photo-bot23/Photo-Bot/Photo-Bot Engineering Drawings/ELECTRONICS ARRANGEMENT.PDF

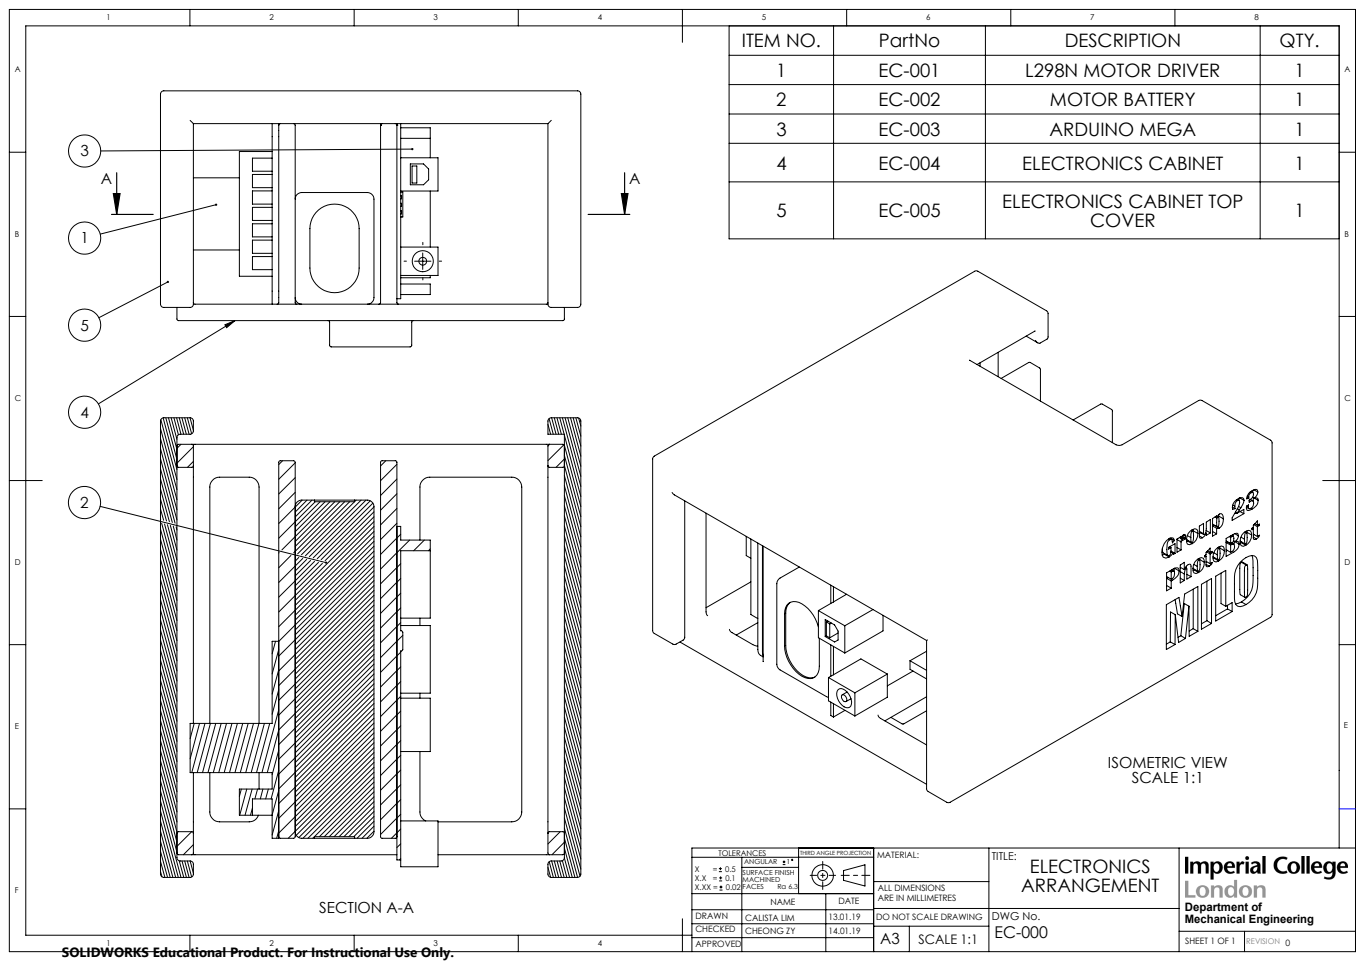
[picture p1: page 1]
ISOMETRIC VIEW SCALE 1:1; SECTION A-A; SURFACE FINISH; FACES; ANGULAR 1; DWG No.; A3 SCALE 1:1; SHEET 1 OF 1; CALISTA LIM CHEONG ZY; REVISION 0; Department of Mechanical Engineering

ITEM NO. | PartNo | DESCRIPTION | QTY.
1 | EC-001 | L298N MOTOR DRIVER | 1
2 | EC-002 | MOTOR BATTERY | 1
3 | EC-003 | ARDUINO MEGA | 1
4 | EC-004 | ELECTRONICS CABINET | 1
5 | EC-005 | ELECTRONICS CABINET TOP COVER | 1

THIRD ANGLE PROJECTION

ALL DIMENSIONS
ARE IN MILLIMETRES
DO NOT SCALE DRAWING

SOLIDWORKS Educational Product. For Instructional Use Only.
