photo-bot23/Photo-Bot/Photo-Bot Engineering Drawings/FRONT SUBASSEMBLY.PDF

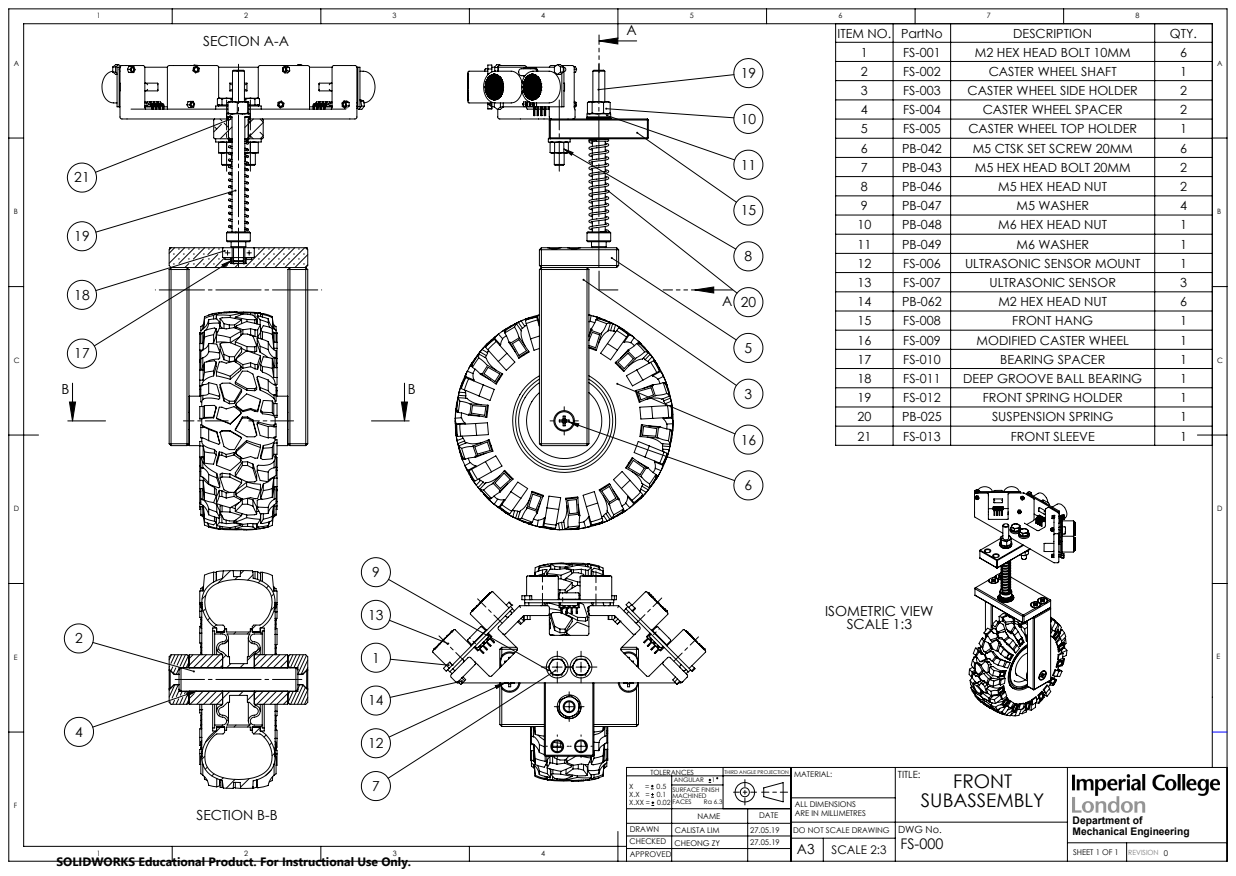
[picture p2: page 1]
ISOMETRIC VIEW SCALE 1:3; SECTION A-A; SECTION B-B; SURFACE FINISH; FACES; ANGULAR 1; FRONT; DWG No.; A3 SCALE 2:3; SHEET 1 OF 1; CALISTA LIM CHEONG ZY; REVISION 0; Department of Mechanical Engineering

ITEM NO. | PartNo | DESCRIPTION | QTY.
1 | FS-001 | M2 HEX HEAD BOLT 10MM | 6
2 | FS-002 | CASTER WHEEL SHAFT | 1
3 | FS-003 | CASTER WHEEL SIDE HOLDER | 2
4 | FS-004 | CASTER WHEEL SPACER | 2
5 | FS-005 | CASTER WHEEL TOP HOLDER | 1
6 | PB-042 | M5 CTSK SET SCREW 20MM | 6
7 | PB-043 | M5 HEX HEAD BOLT 20MM | 2
8 | PB-046 | M5 HEX HEAD NUT | 2
9 | PB-047 | M5 WASHER | 4
10 | PB-048 | M6 HEX HEAD NUT | 1
11 | PB-049 | M6 WASHER | 1
12 | FS-006 | ULTRASONIC SENSOR MOUNT | 1
13 | FS-007 | ULTRASONIC SENSOR | 3
14 | PB-062 | M2 HEX HEAD NUT | 6
15 | FS-008 | FRONT HANG | 1
16 | FS-009 | MODIFIED CASTER WHEEL | 1
17 | FS-010 | BEARING SPACER | 1
18 | FS-011 | DEEP GROOVE BALL BEARING | 1
19 | FS-012 | FRONT SPRING HOLDER | 1
20 | PB-025 | SUSPENSION SPRING | 1
21 | FS-013 | FRONT SLEEVE | 1

THIRD ANGLE PROJECTION

ALL DIMENSIONS
ARE IN MILLIMETRES
DO NOT SCALE DRAWING

SOLIDWORKS Educational Product. For Instructional Use Only.
