photo-bot23/Photo-Bot/Photo-Bot Engineering Drawings/GIMBAL ASSEMBLY.PDF

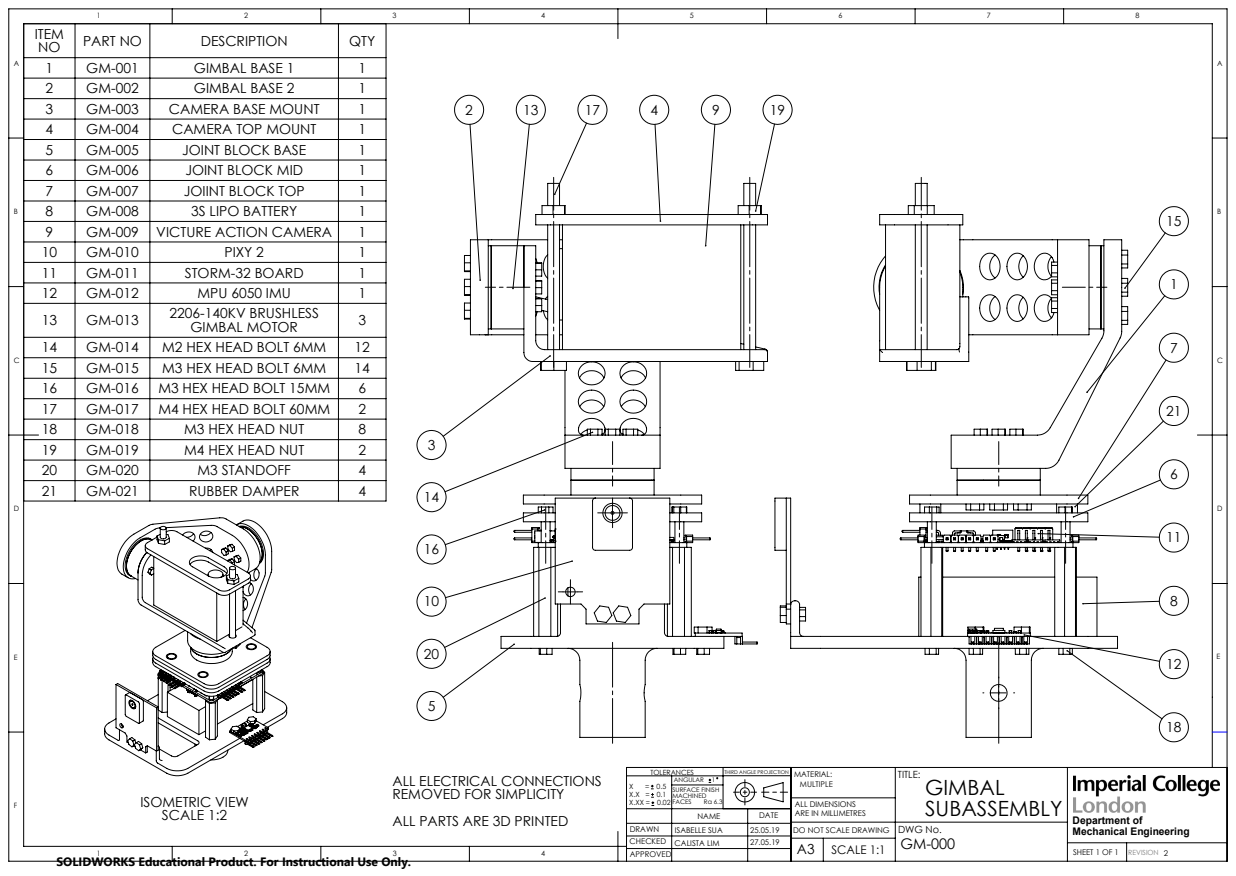
[picture p3: page 1]
ISOMETRIC VIEW SCALE 1:2; SURFACE FINISH; FACES; ANGULAR 1; DWG No.; A3 SCALE 1:1; SHEET 1 OF 1; ISABELLE SUA CALISTA LIM; REVISION 2; Department of Mechanical Engineering

ITEM NO | PART NO | DESCRIPTION | QTY
1 | GM-001 | GIMBAL BASE 1 | 1
2 | GM-002 | GIMBAL BASE 2 | 1
3 | GM-003 | CAMERA BASE MOUNT | 1
4 | GM-004 | CAMERA TOP MOUNT | 1
5 | GM-005 | JOINT BLOCK BASE | 1
6 | GM-006 | JOINT BLOCK MID | 1
7 | GM-007 | JOIINT BLOCK TOP | 1
8 | GM-008 | 3S LIPO BATTERY | 1
9 | GM-009 | VICTURE ACTION CAMERA | 1
10 | GM-010 | PIXY 2 | 1
11 | GM-011 | STORM-32 BOARD | 1
12 | GM-012 | MPU 6050 IMU | 1
13 | GM-013 | 2206-140KV BRUSHLESS GIMBAL MOTOR | 3
14 | GM-014 | M2 HEX HEAD BOLT 6MM | 12
15 | GM-015 | M3 HEX HEAD BOLT 6MM | 14
16 | GM-016 | M3 HEX HEAD BOLT 15MM | 6
17 | GM-017 | M4 HEX HEAD BOLT 60MM | 2
18 | GM-018 | M3 HEX HEAD NUT | 8
19 | GM-019 | M4 HEX HEAD NUT | 2
20 | GM-020 | M3 STANDOFF | 4
21 | GM-021 | RUBBER DAMPER | 4

THIRD ANGLE PROJECTION

MATERIAL:
MULTIPLE
ALL DIMENSIONS
ARE IN MILLIMETRES
DO NOT SCALE DRAWING

ALL ELECTRICAL CONNECTIONS
REMOVED FOR SIMPLICITY
ALL PARTS ARE 3D PRINTED

SOLIDWORKS Educational Product. For Instructional Use Only.
