photo-bot23/Photo-Bot/Photo-Bot Engineering Drawings/FRONT SUBASSEMBLY/FS-002 CASTER WHEEL SHAFT.PDF

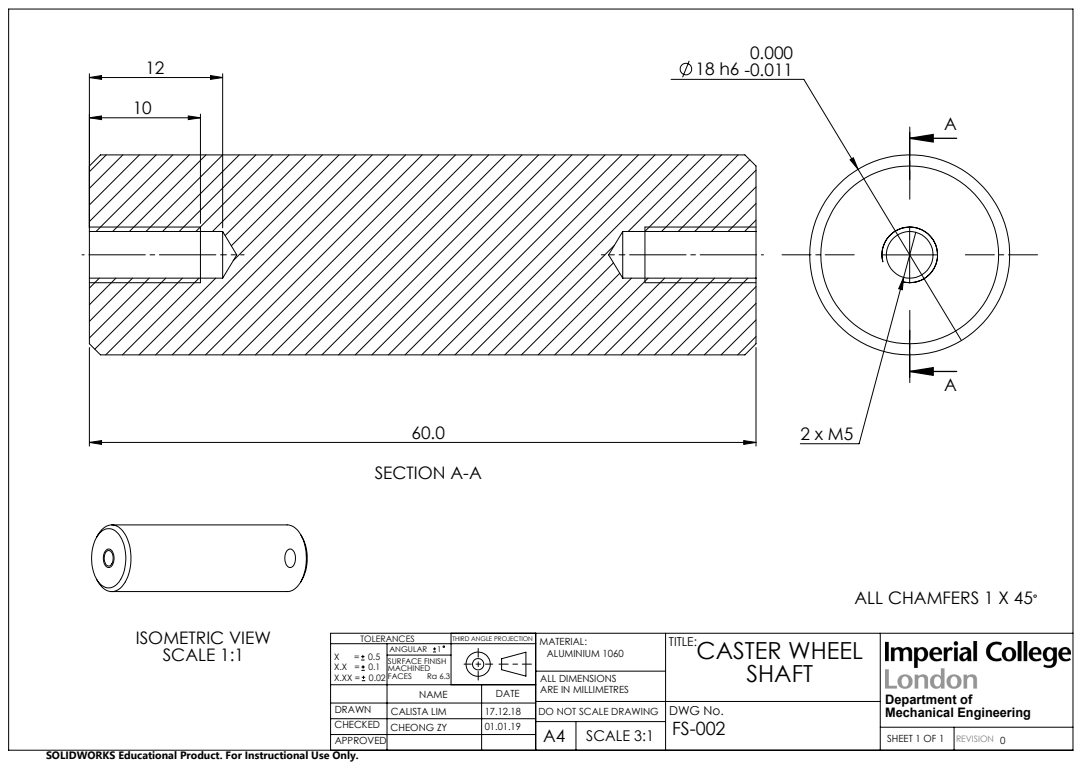
[picture p4: page 1]
SECTION A-A; ALL CHAMFERS 1 X 45°; ISOMETRIC VIEW; SCALE 1:1; SURFACE FINISH; FACES; ANGULAR 1; CASTER WHEEL; DWG No.; A4 SCALE 3:1; SHEET 1 OF 1; CALISTA LIM CHEONG ZY; REVISION 0; Department of Mechanical Engineering

THIRD ANGLE PROJECTION

MATERIAL:
ALUMINIUM 1060
ALL DIMENSIONS
ARE IN MILLIMETRES
DO NOT SCALE DRAWING

SOLIDWORKS Educational Product. For Instructional Use Only.
