photo-bot23/Photo-Bot/Photo-Bot Engineering Drawings/FRONT SUBASSEMBLY/FS-003 CASTER WHEELSIDE HOLDER.PDF

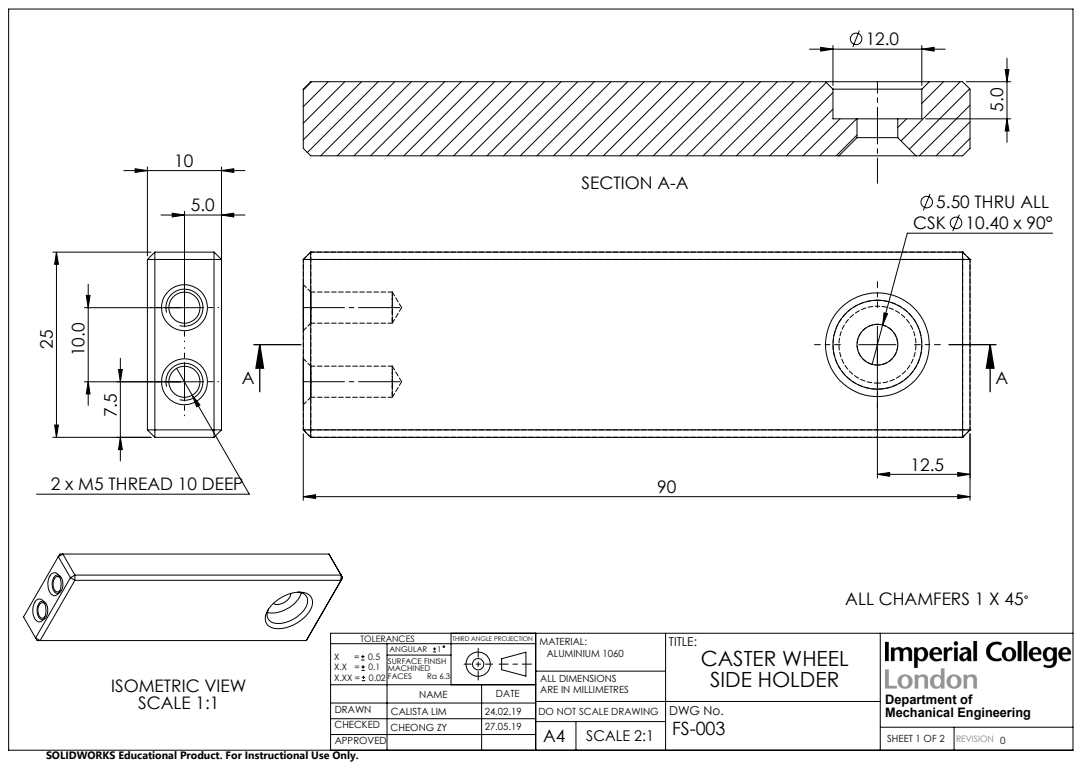
[picture p5: page 1]
5.50 THRU ALL CSK 10.40 x 90°; SECTION A-A; 2 x M5 THREAD 10 DEEP; ISOMETRIC VIEW SCALE 1:1; ALL CHAMFERS 1 X 45°; SURFACE FINISH; FACES; ANGULAR 1; CASTER WHEEL SIDE HOLDER; DWG No.; A4 SCALE 2:1; SHEET 1 OF 2; CALISTA LIM CHEONG ZY; REVISION 0; Department of Mechanical Engineering

THIRD ANGLE PROJECTION

MATERIAL:
ALUMINIUM 1060
ALL DIMENSIONS
ARE IN MILLIMETRES
DO NOT SCALE DRAWING

SOLIDWORKS Educational Product. For Instructional Use Only.
