photo-bot23/Photo-Bot/Photo-Bot Engineering Drawings/FRONT SUBASSEMBLY/FS-004 CASTER WHEEL SPACER.PDF

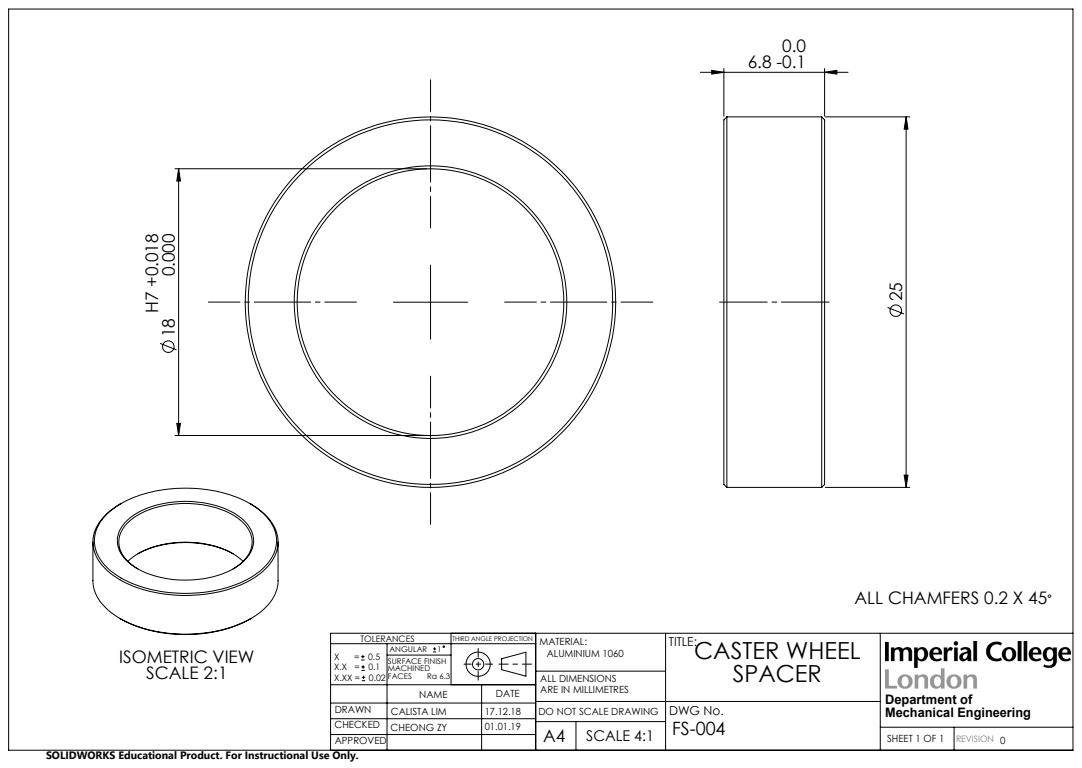
[picture p6: page 1]
ISOMETRIC VIEW SCALE 2:1; ALL CHAMFERS 0.2 X 45°; SURFACE FINISH; FACES; ANGULAR 1; CASTER WHEEL; DWG No.; A4 SCALE 4:1; SHEET 1 OF 1; CALISTA LIM CHEONG ZY; REVISION 0; Department of Mechanical Engineering

THIRD ANGLE PROJECTION

MATERIAL:
ALUMINIUM 1060
ALL DIMENSIONS
ARE IN MILLIMETRES
DO NOT SCALE DRAWING

SOLIDWORKS Educational Product. For Instructional Use Only.
