photo-bot23/Photo-Bot/Photo-Bot Engineering Drawings/FRONT SUBASSEMBLY/FS-005 CASTER WHEEL TOP HOLDER.PDF

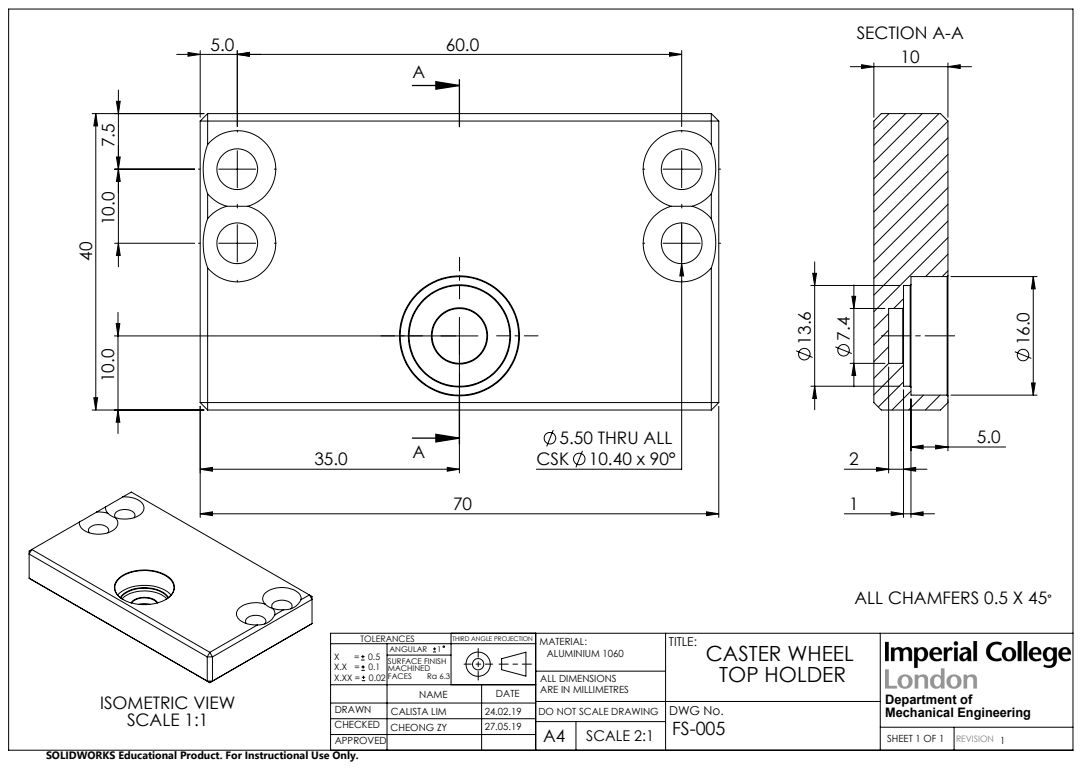
[picture p7: page 1]
5.50 THRU ALL CSK 10.40 x 90°; SECTION A-A; ALL CHAMFERS 0.5 X 45°; ISOMETRIC VIEW SCALE 1:1; SURFACE FINISH; FACES; ANGULAR 1; CASTER WHEEL TOP HOLDER; DWG No.; A4 SCALE 2:1; SHEET 1 OF 1; CALISTA LIM CHEONG ZY; REVISION 1; Department of Mechanical Engineering

THIRD ANGLE PROJECTION

MATERIAL:
ALUMINIUM 1060
ALL DIMENSIONS
ARE IN MILLIMETRES
DO NOT SCALE DRAWING

SOLIDWORKS Educational Product. For Instructional Use Only.
