photo-bot23/Photo-Bot/Photo-Bot Engineering Drawings/FRONT SUBASSEMBLY/FS-010 BEARING SPACER.PDF

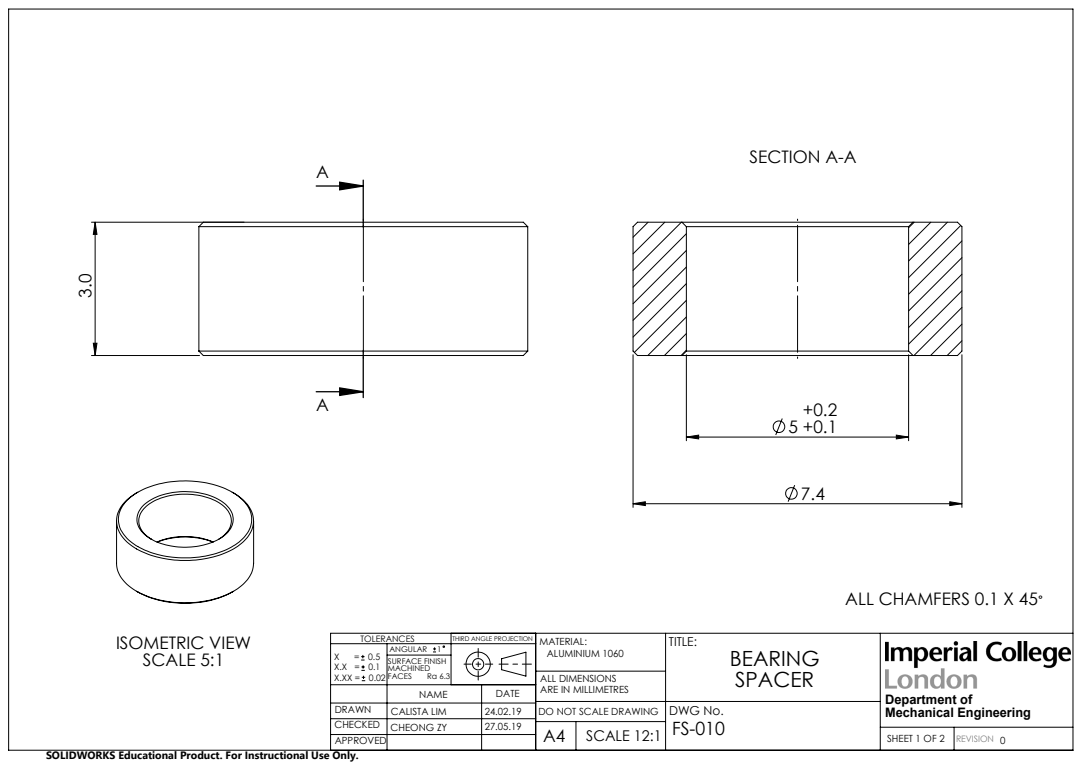
[picture p8: page 1]
SECTION A-A; ALL CHAMFERS 0.1 X 45°; ISOMETRIC VIEW; SCALE 5:1; SURFACE FINISH; FACES; ANGULAR 1; DWG No.; A4 SCALE 12:1; SHEET 1 OF 2; CALISTA LIM CHEONG ZY; REVISION 0; Department of Mechanical Engineering

THIRD ANGLE PROJECTION

MATERIAL:
ALUMINIUM 1060
ALL DIMENSIONS
ARE IN MILLIMETRES
DO NOT SCALE DRAWING

SOLIDWORKS Educational Product. For Instructional Use Only.
