photo-bot23/Photo-Bot/Photo-Bot Engineering Drawings/FRONT SUBASSEMBLY/FS-012 FRONT SPRING HOLDER.PDF

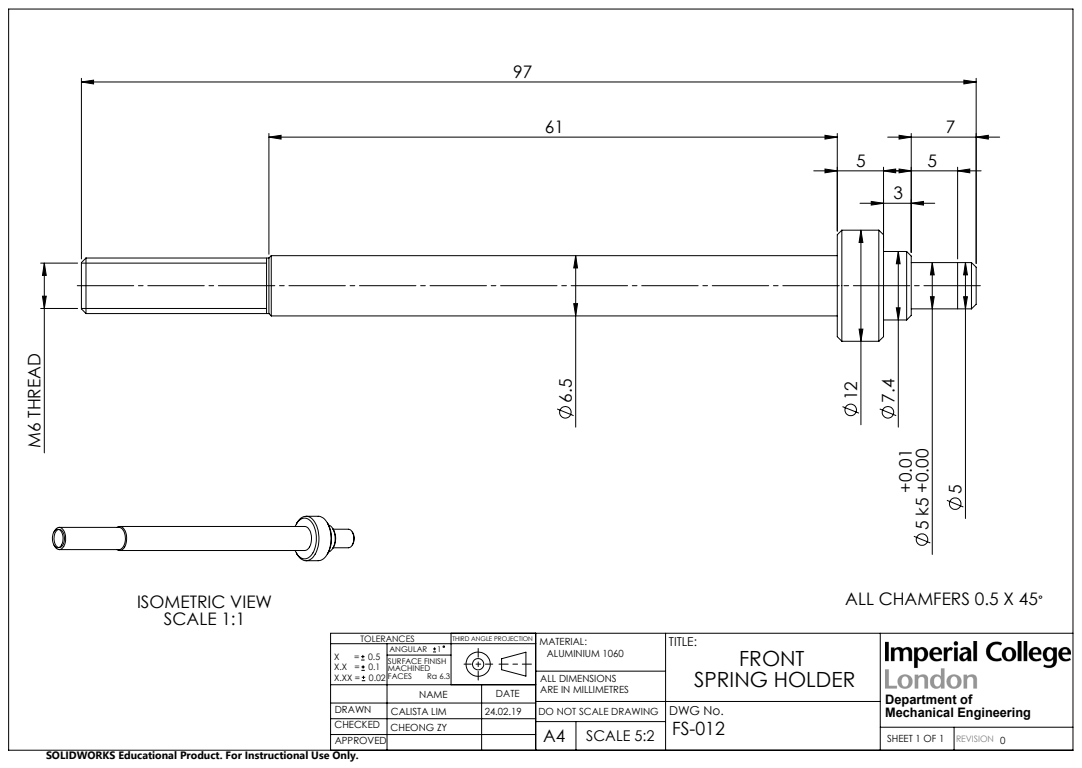
[picture p9: page 1]
M6 THREAD; ISOMETRIC VIEW SCALE 1:1; ALL CHAMFERS 0.5 X 45°; SURFACE FINISH; FACES; ANGULAR 1; SPRING HOLDER; DWG No.; A4 SCALE 5:2; SHEET 1 OF 1; CALISTA LIM CHEONG ZY; REVISION 0; Department of Mechanical Engineering

THIRD ANGLE PROJECTION

MATERIAL:
ALUMINIUM 1060
ALL DIMENSIONS
ARE IN MILLIMETRES
DO NOT SCALE DRAWING

SOLIDWORKS Educational Product. For Instructional Use Only.
