photo-bot23/Photo-Bot/Photo-Bot Engineering Drawings/FRONT SUBASSEMBLY/FS-013 FRONT SLEEVE.PDF

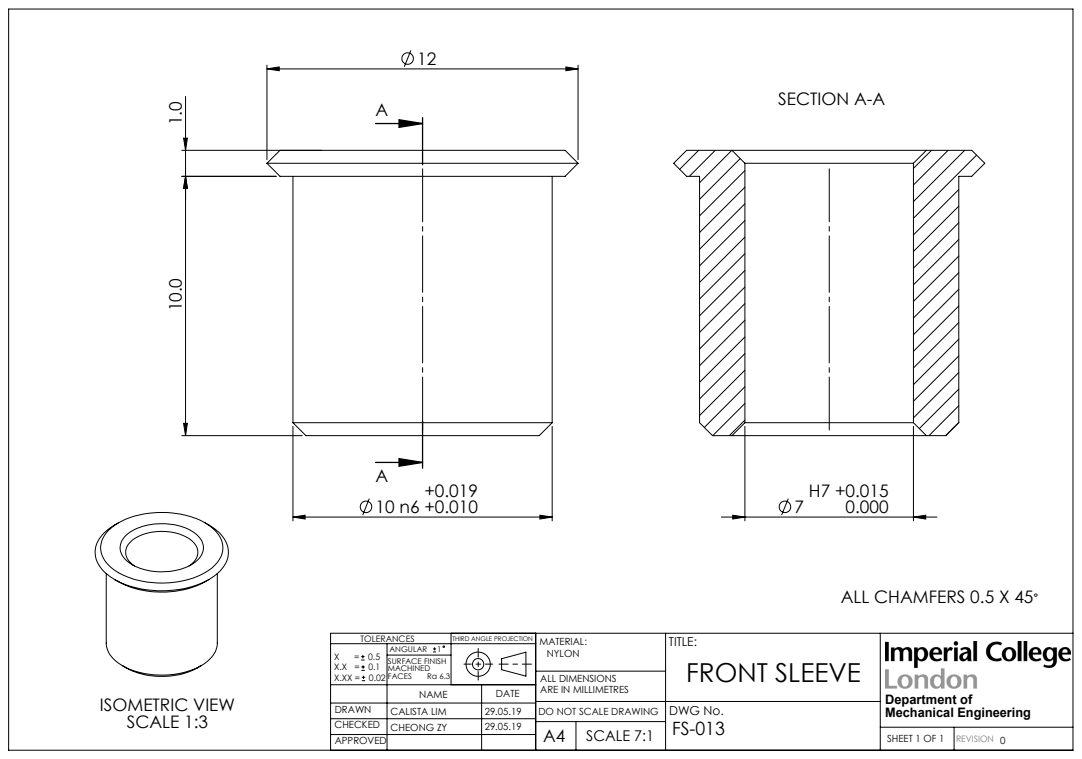
[picture p10: page 1]
SECTION A-A; ISOMETRIC VIEW SCALE 1:3; ALL CHAMFERS 0.5 X 45°; SURFACE FINISH; FACES; ANGULAR 1; FRONT SLEEVE; DWG No.; A4 SCALE 7:1; SHEET 1 OF 1; CALISTA LIM CHEONG ZY; REVISION 0; Department of Mechanical Engineering

THIRD ANGLE PROJECTION

MATERIAL:
NYLON
ALL DIMENSIONS
ARE IN MILLIMETRES
DO NOT SCALE DRAWING
