photo-bot23/Photo-Bot/Photo-Bot Engineering Drawings/MAIN PHOTOBOT/PB-004 25MM HINGE PIN.PDF

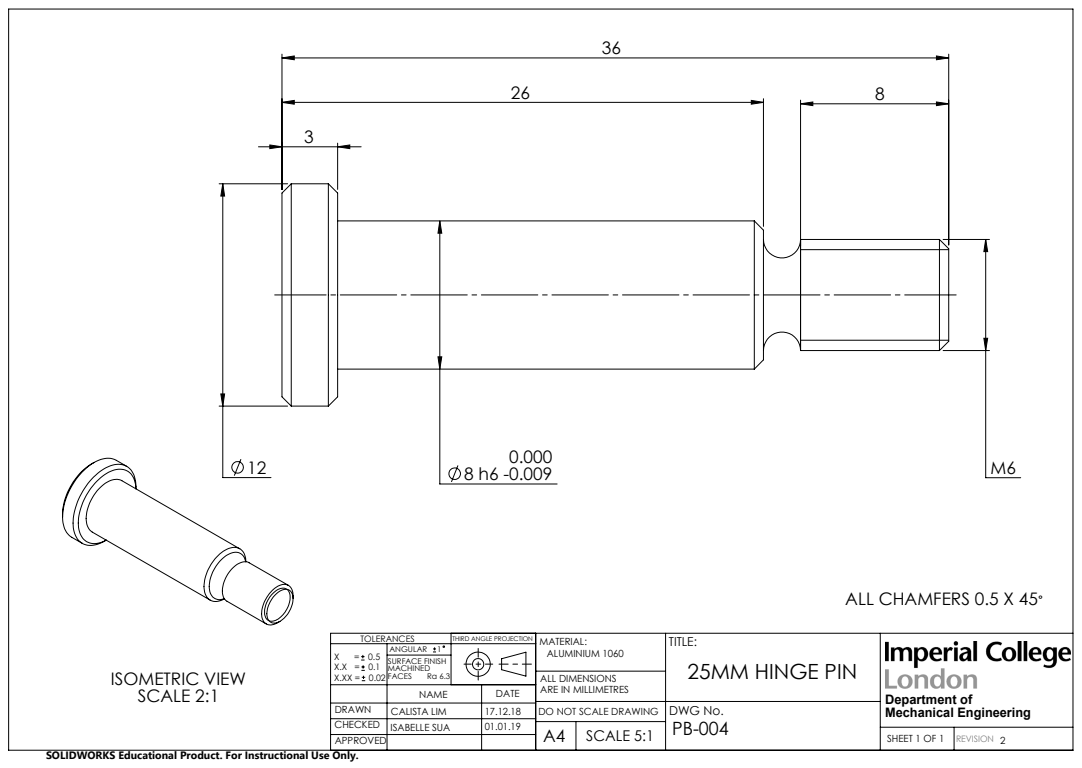
[picture p14: page 1]
ISOMETRIC VIEW SCALE 2:1; ALL CHAMFERS 0.5 X 45°; SURFACE FINISH; FACES; ANGULAR 1; 25MM HINGE PIN; DWG No.; A4 SCALE 5:1; SHEET 1 OF 1; CALISTA LIM ISABELLE SUA; REVISION 2; Department of Mechanical Engineering

THIRD ANGLE PROJECTION

MATERIAL:
ALUMINIUM 1060
ALL DIMENSIONS
ARE IN MILLIMETRES
DO NOT SCALE DRAWING

SOLIDWORKS Educational Product. For Instructional Use Only.
