photo-bot23/Photo-Bot/Photo-Bot Engineering Drawings/MAIN PHOTOBOT/PB-005 FRONT BAR.PDF

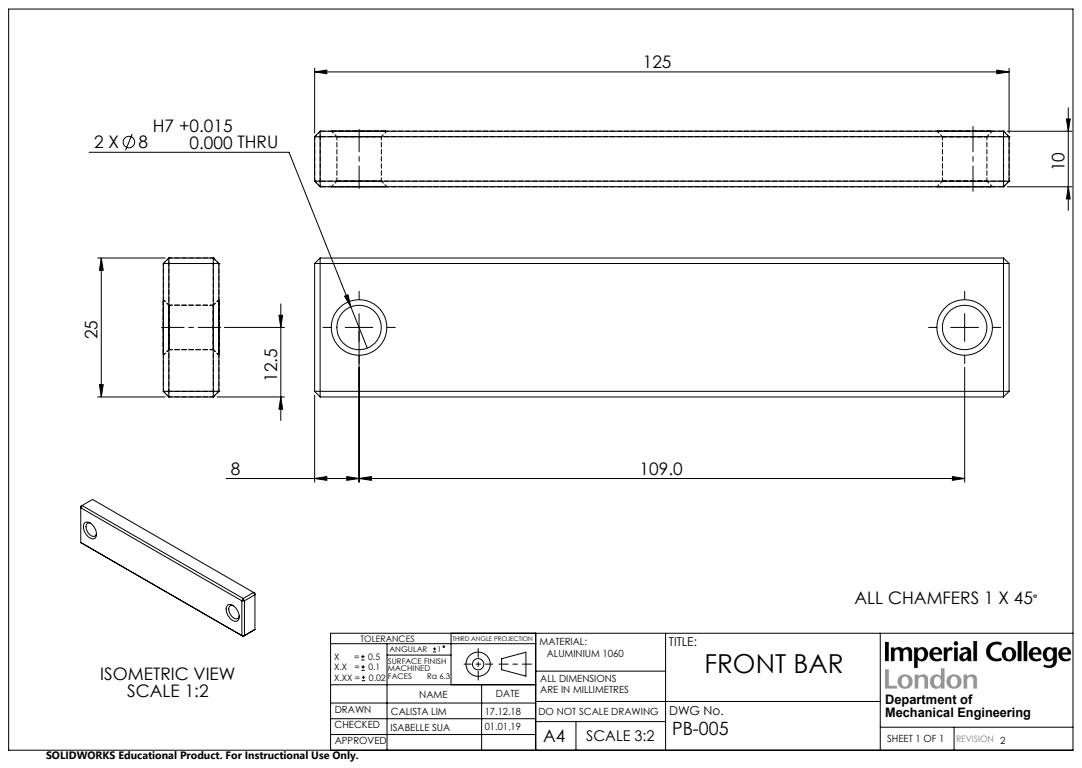
[picture p15: page 1]
H7 +0.015 0.000 THRU; ALL CHAMFERS 1 X 45°; ISOMETRIC VIEW SCALE 1:2; SURFACE FINISH; FACES; ANGULAR 1; FRONT BAR; DWG No.; A4 SCALE 3:2; SHEET 1 OF 1; CALISTA LIM ISABELLE SUA; REVISION 2; Department of Mechanical Engineering

THIRD ANGLE PROJECTION

MATERIAL:
ALUMINIUM 1060
ALL DIMENSIONS
ARE IN MILLIMETRES
DO NOT SCALE DRAWING

SOLIDWORKS Educational Product. For Instructional Use Only.
