photo-bot23/Photo-Bot/Photo-Bot Engineering Drawings/MAIN PHOTOBOT/PB-007 HEIGHT SPACER.PDF

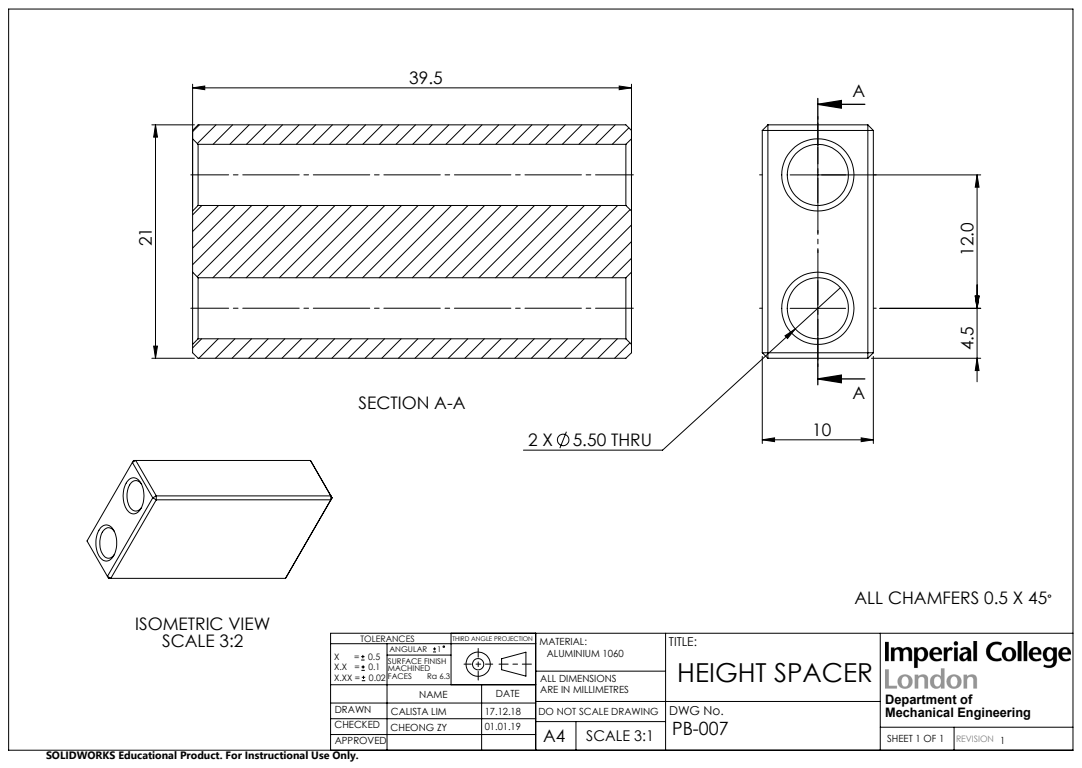
[picture p16: page 1]
10 2 X 5.50 THRU; SECTION A-A; ISOMETRIC VIEW SCALE 3:2; ALL CHAMFERS 0.5 X 45°; SURFACE FINISH; FACES; ANGULAR 1; HEIGHT SPACER; DWG No.; A4 SCALE 3:1; SHEET 1 OF 1; CALISTA LIM CHEONG ZY; REVISION 1; Department of Mechanical Engineering

THIRD ANGLE PROJECTION

MATERIAL:
ALUMINIUM 1060
ALL DIMENSIONS
ARE IN MILLIMETRES
DO NOT SCALE DRAWING

SOLIDWORKS Educational Product. For Instructional Use Only.
