photo-bot23/Photo-Bot/Photo-Bot Engineering Drawings/MAIN PHOTOBOT/PB-008 MAST HINGE BLOCK.PDF

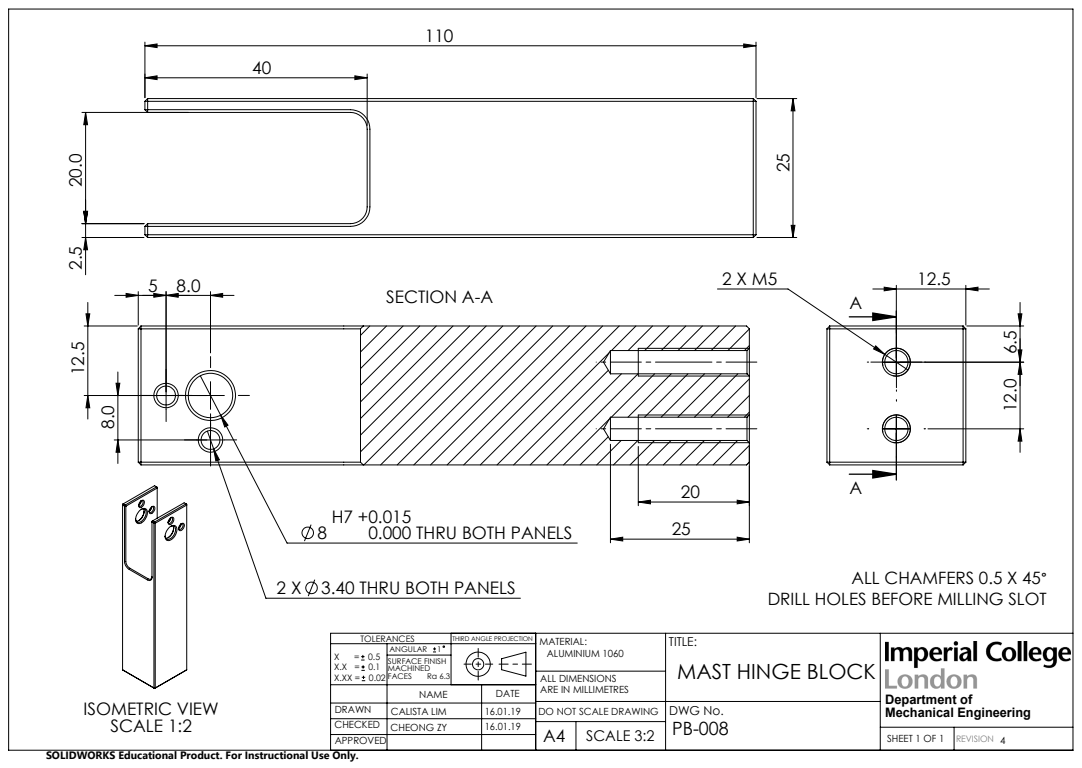
[picture p17: page 1]
H7 +0.015 0.000 THRU BOTH PANELS; SECTION A-A; ALL CHAMFERS 0.5 X 45°; ISOMETRIC VIEW SCALE 1:2; SURFACE FINISH; FACES; ANGULAR 1; DWG No.; A4 SCALE 3:2; SHEET 1 OF 1; CALISTA LIM CHEONG ZY; REVISION 4; Department of Mechanical Engineering

2 X 3.40 THRU BOTH PANELS

DRILL HOLES BEFORE MILLING SLOT

THIRD ANGLE PROJECTION

MATERIAL:
ALUMINIUM 1060
ALL DIMENSIONS
ARE IN MILLIMETRES
DO NOT SCALE DRAWING

TITLE:
MAST HINGE BLOCK

SOLIDWORKS Educational Product. For Instructional Use Only.
