photo-bot23/Photo-Bot/Photo-Bot Engineering Drawings/MAIN PHOTOBOT/PB-012 MOTOR MOUNT BASE.PDF

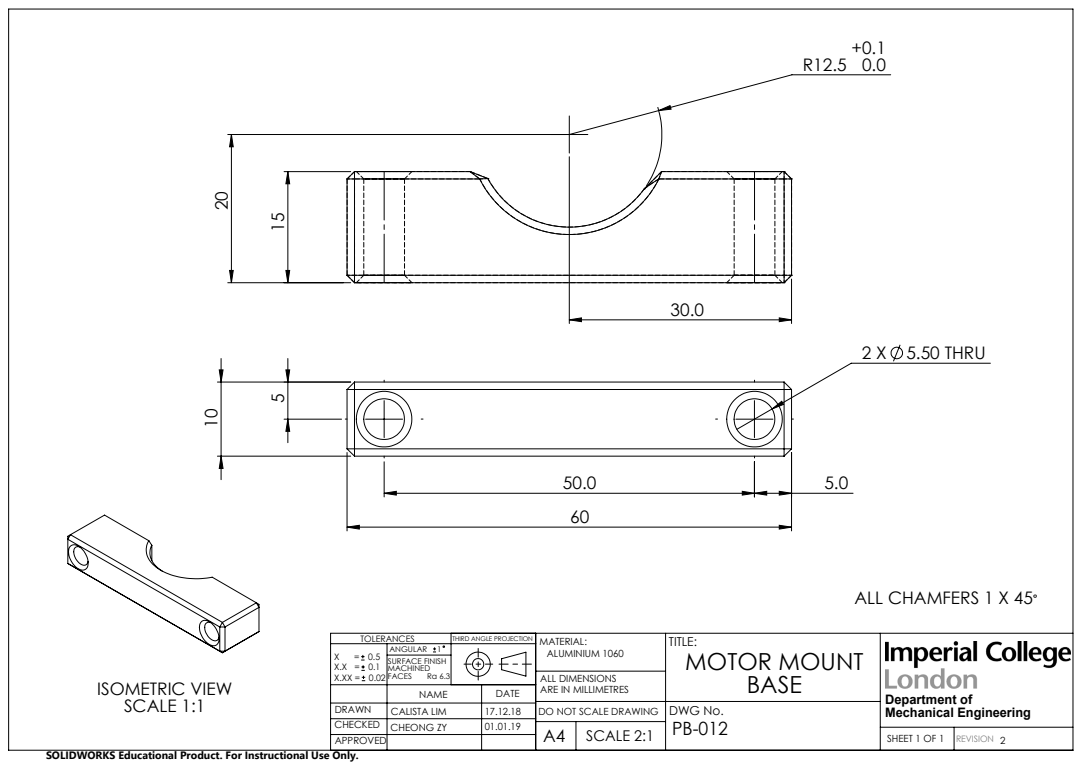
[picture p18: page 1]
2 X 5.50 THRU; ALL CHAMFERS 1 X 45°; ISOMETRIC VIEW SCALE 1:1; SURFACE FINISH; FACES; ANGULAR 1; MOTOR MOUNT; DWG No.; A4 SCALE 2:1; SHEET 1 OF 1; CALISTA LIM CHEONG ZY; REVISION 2; Department of Mechanical Engineering

THIRD ANGLE PROJECTION

MATERIAL:
ALUMINIUM 1060
ALL DIMENSIONS
ARE IN MILLIMETRES
DO NOT SCALE DRAWING

SOLIDWORKS Educational Product. For Instructional Use Only.
