photo-bot23/Photo-Bot/Photo-Bot Engineering Drawings/MAIN PHOTOBOT/PB-017 REAR BAR.PDF

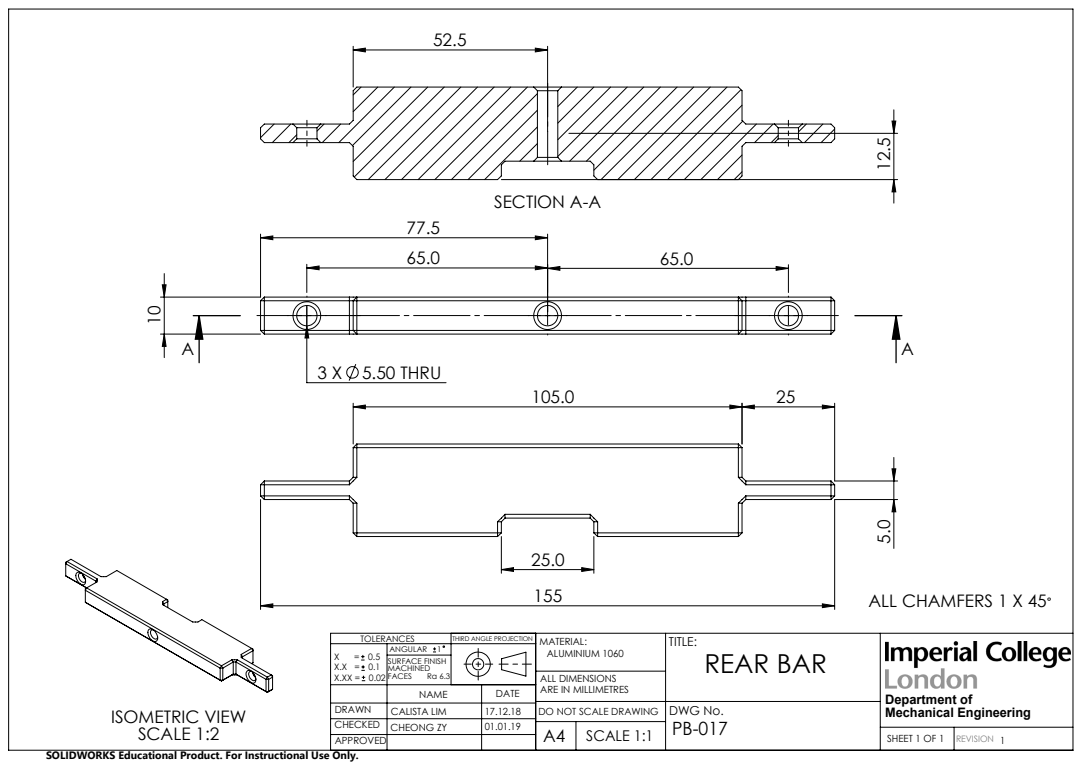
[picture p19: page 1]
3 X 5.50 THRU; SECTION A-A; ISOMETRIC VIEW SCALE 1:2; ALL CHAMFERS 1 X 45°; SURFACE FINISH; FACES; ANGULAR 1; REAR BAR; DWG No.; A4 SCALE 1:1; SHEET 1 OF 1; CALISTA LIM CHEONG ZY; REVISION 1; Department of Mechanical Engineering

THIRD ANGLE PROJECTION

MATERIAL:
ALUMINIUM 1060
ALL DIMENSIONS
ARE IN MILLIMETRES
DO NOT SCALE DRAWING

SOLIDWORKS Educational Product. For Instructional Use Only.
