photo-bot23/Photo-Bot/Photo-Bot Engineering Drawings/MAIN PHOTOBOT/PB-018 SIDE BAR PORT.PDF

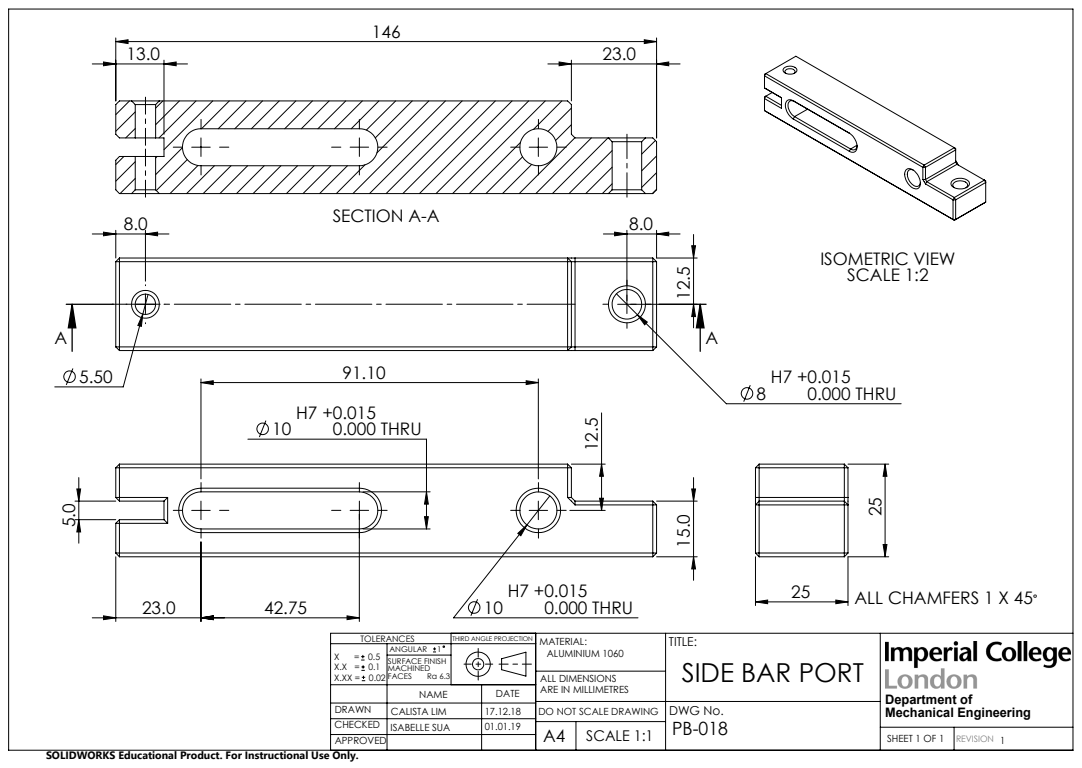
[picture p20: page 1]
H7 +0.015 0.000 THRU; SECTION A-A; ALL CHAMFERS 1 X 45°; ISOMETRIC VIEW SCALE 1:2; SURFACE FINISH; FACES; ANGULAR 1; DWG No.; A4 SCALE 1:1; SHEET 1 OF 1; CALISTA LIM ISABELLE SUA; REVISION 1; Department of Mechanical Engineering

THIRD ANGLE PROJECTION

MATERIAL:
ALUMINIUM 1060
ALL DIMENSIONS
ARE IN MILLIMETRES
DO NOT SCALE DRAWING

TITLE:
SIDE BAR PORT

SOLIDWORKS Educational Product. For Instructional Use Only.
