photo-bot23/Photo-Bot/Photo-Bot Engineering Drawings/MAIN PHOTOBOT/PB-019 SLOT CLAMP.PDF

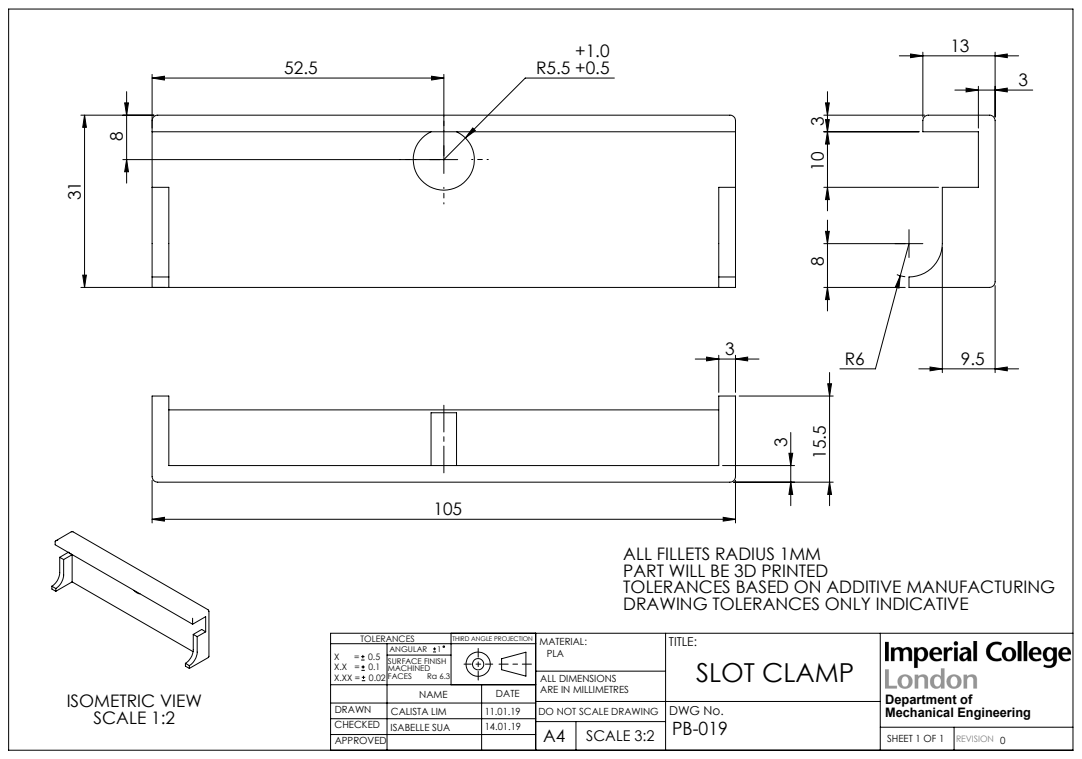
[picture p21: page 1]
ISOMETRIC VIEW SCALE 1:2; SURFACE FINISH; FACES; ANGULAR 1; DWG No.; A4 SCALE 3:2; SHEET 1 OF 1; CALISTA LIM ISABELLE SUA; REVISION 0; Department of Mechanical Engineering

ALL FILLETS RADIUS 1MM
PART WILL BE 3D PRINTED
TOLERANCES BASED ON ADDITIVE MANUFACTURING
DRAWING TOLERANCES ONLY INDICATIVE
SLOT CLAMP

THIRD ANGLE PROJECTION

MATERIAL:
PLA
ALL DIMENSIONS
ARE IN MILLIMETRES
DO NOT SCALE DRAWING
