photo-bot23/Photo-Bot/Photo-Bot Engineering Drawings/MAIN PHOTOBOT/PB-020 SPINE BAR.pdf

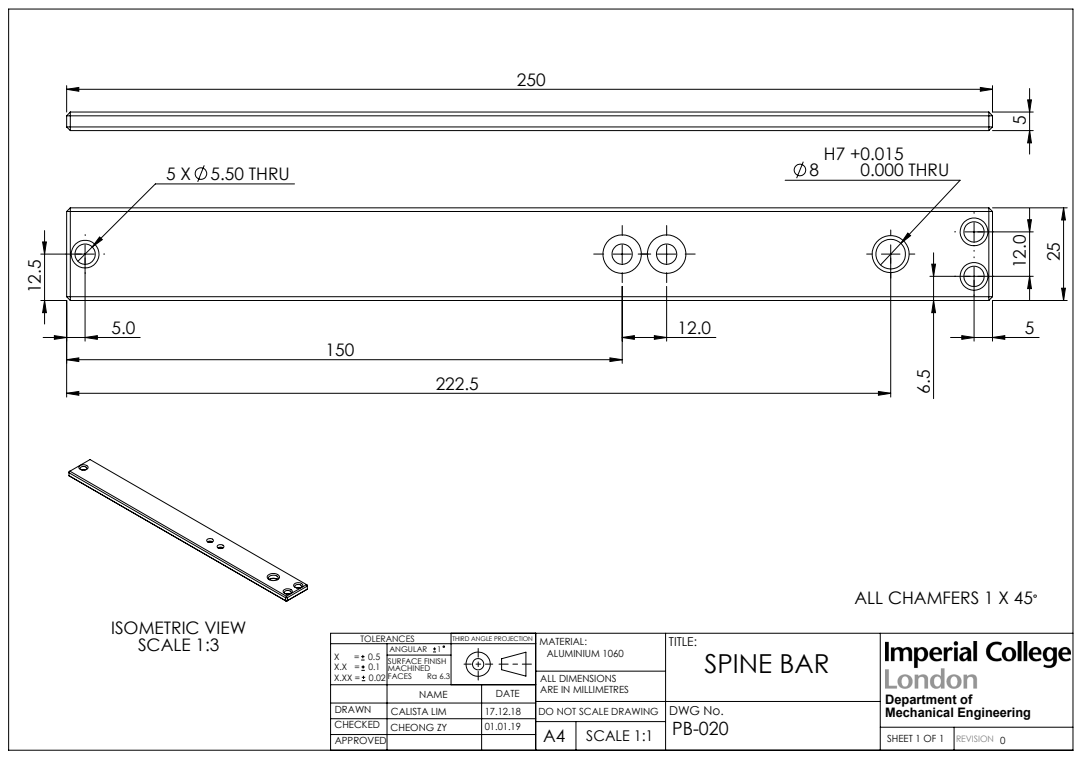
[picture p22: page 1]
5 X 5.50 THRU; H7 +0.015 0.000 THRU; ISOMETRIC VIEW SCALE 1:3; ALL CHAMFERS 1 X 45°; SURFACE FINISH; FACES; ANGULAR 1; SPINE BAR; DWG No.; A4 SCALE 1:1; SHEET 1 OF 1; CALISTA LIM CHEONG ZY; REVISION 0; Department of Mechanical Engineering

THIRD ANGLE PROJECTION

MATERIAL:
ALUMINIUM 1060
ALL DIMENSIONS
ARE IN MILLIMETRES
DO NOT SCALE DRAWING
