photo-bot23/Photo-Bot/Photo-Bot Engineering Drawings/MAIN PHOTOBOT/PB-022 SUSPENSION TOP FITTING.PDF

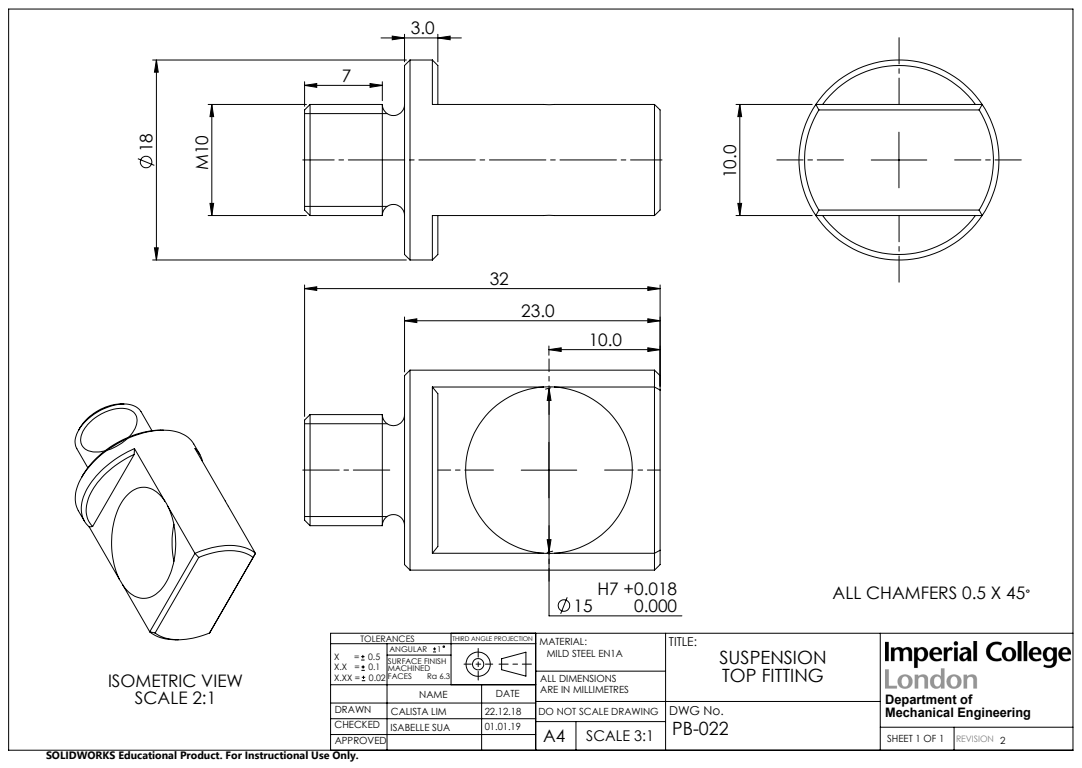
[picture p23: page 1]
ALL CHAMFERS 0.5 X 45°; ISOMETRIC VIEW SCALE 2:1; SURFACE FINISH; FACES; ANGULAR 1; TOP FITTING; DWG No.; A4 SCALE 3:1; SHEET 1 OF 1; CALISTA LIM ISABELLE SUA; REVISION 2; Department of Mechanical Engineering

THIRD ANGLE PROJECTION

MATERIAL:
MILD STEEL EN1A
ALL DIMENSIONS
ARE IN MILLIMETRES
DO NOT SCALE DRAWING

SOLIDWORKS Educational Product. For Instructional Use Only.
