photo-bot23/Photo-Bot/Photo-Bot Engineering Drawings/MAIN PHOTOBOT/PB-027 SUSPENSION BUSH BEARING THICK.PDF

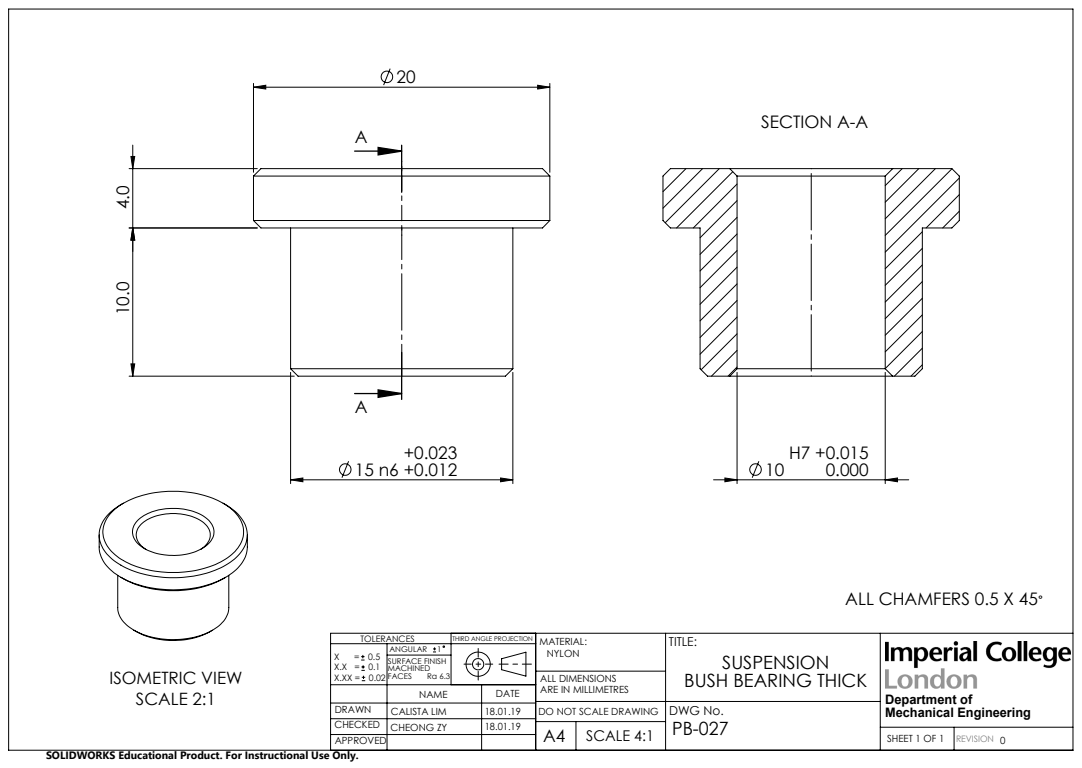
[picture p24: page 1]
ISOMETRIC VIEW SCALE 2:1; SECTION A-A; ALL CHAMFERS 0.5 X 45°; SURFACE FINISH; FACES; ANGULAR 1; DWG No.; A4 SCALE 4:1; SHEET 1 OF 1; CALISTA LIM CHEONG ZY; REVISION 0; Department of Mechanical Engineering

THIRD ANGLE PROJECTION

MATERIAL:
NYLON
ALL DIMENSIONS
ARE IN MILLIMETRES
DO NOT SCALE DRAWING

TITLE:
SUSPENSION
BUSH BEARING THICK

SOLIDWORKS Educational Product. For Instructional Use Only.
