photo-bot23/Photo-Bot/Photo-Bot Engineering Drawings/MAIN PHOTOBOT/PB-034 WHEEL SHAFT CAP.PDF

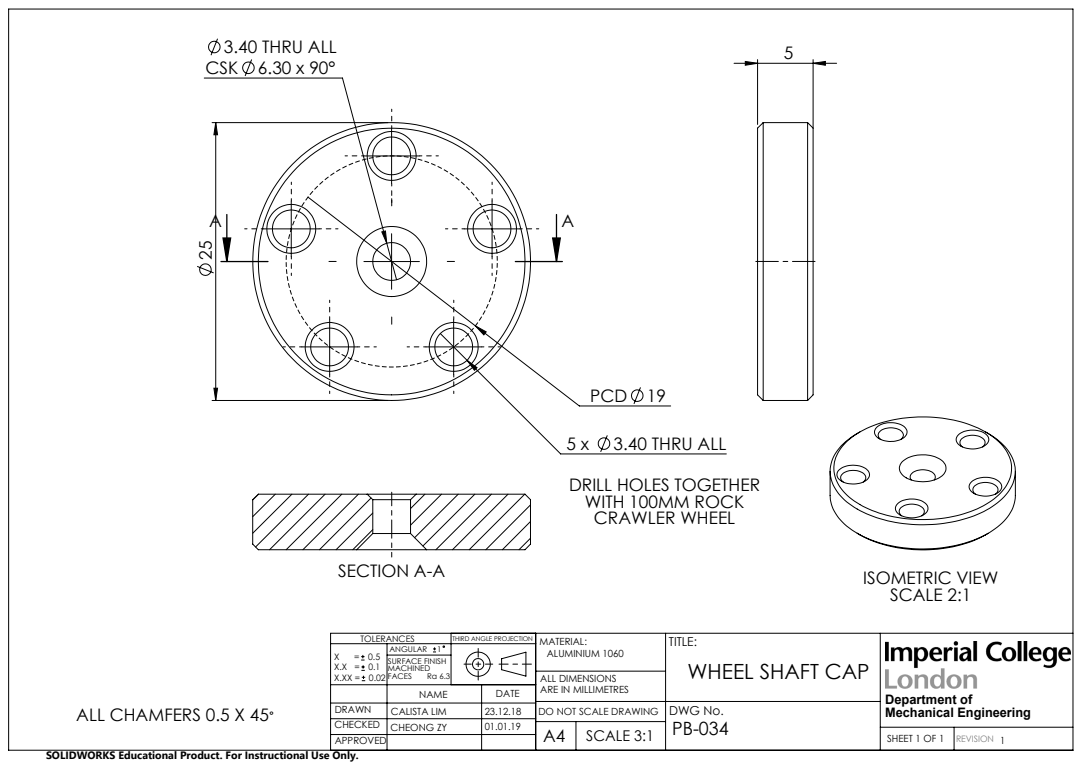
[picture p25: page 1]
3.40 THRU ALL CSK 6.30 x 90°; PCD 19; ISOMETRIC VIEW SCALE 2:1; SECTION A-A; ALL CHAMFERS 0.5 X 45°; SURFACE FINISH; FACES; ANGULAR 1; DWG No.; A4 SCALE 3:1; SHEET 1 OF 1; CALISTA LIM CHEONG ZY; REVISION 1; Department of Mechanical Engineering

5 x 3.40 THRU ALL
DRILL HOLES TOGETHER
WITH 100MM ROCK
CRAWLER WHEEL

THIRD ANGLE PROJECTION

MATERIAL:
ALUMINIUM 1060
ALL DIMENSIONS
ARE IN MILLIMETRES
DO NOT SCALE DRAWING

TITLE:
WHEEL SHAFT CAP

SOLIDWORKS Educational Product. For Instructional Use Only.
